LeBaggett/Control-Device-Electral-Method/hardware/mvp/communication/README.md

# RS-485 e conexões

Transceptores MAX485, níveis elétricos, DE/RE, terminação e barramentos independentes de IHM/sensores.

Estado: estrutura inicial criada em 26/10/2026.

Validar compatibilidade entre transceptor de 5 V e pinos de 3,3 V; não unir mestres RTU no mesmo barramento.

## Manutenção

Implementações futuras devem manter as responsabilidades desta camada e atualizar este README com os arquivos efetivamente criados. Arquivos de outras gerações não devem ser copiados sem revisão de interfaces e premissas.
