LeBaggett/Control-Device-Electral-Method/fw/Control_Device_Electral_Method_MVP/Drivers/README.md

# Dependências ST/ARM

Destino das bibliotecas geradas para o H753. Não há HAL/CMSIS H7 importados nesta etapa.

Estado: estrutura inicial criada em 26/10/2026.

Preservar licenças e manter fontes/headers compatíveis com o pacote STM32CubeH7 selecionado.

## Subpastas

- [CMSIS](CMSIS/README.md)
- [STM32H7xx_HAL_Driver](STM32H7xx_HAL_Driver/README.md)

## Manutenção

Implementações futuras devem manter as responsabilidades desta camada e atualizar este README com os arquivos efetivamente criados. Arquivos de outras gerações não devem ser copiados sem revisão de interfaces e premissas.
