LeBaggett/Control-Device-Electral-Method/fw/testbench/MVP_H753_Hardware_Bench/tools/README.md

# Ferramentas

build.py compila com GCC ARM; embed_web.py atualiza o array da página. Não modificam CubeIDE global nem gravam a placa.
