LeBaggett/Control-Device-Electral-Method/fw/Control_Device_Electral_Method_MVP/Application/interfaces/README.md

# Contratos de integração

Tipos e interfaces compartilhados por core, drivers e adaptadores HTTP/Modbus.

Estado: estrutura inicial criada em 26/10/2026.

Definir unidades, estados, validade e idade das três temperaturas, identificador da sessão, comandos e códigos de falha. IHM e navegador devem obedecer aos mesmos estados e arbitragem de comandos.

## Manutenção

Implementações futuras devem manter as responsabilidades desta camada e atualizar este README com os arquivos efetivamente criados. Arquivos de outras gerações não devem ser copiados sem revisão de interfaces e premissas.
