LeBaggett/Control-Device-Electral-Method/fw/Control_Device_Electral_Method_MVP/Core/Inc/README.md

# Headers gerados

Destino de main.h, stm32h7xx_it.h e configuração HAL do H753.

Estado: estrutura inicial criada em 26/10/2026.

Não copiar definições de STM32F407 para esta pasta.

## Manutenção

Implementações futuras devem manter as responsabilidades desta camada e atualizar este README com os arquivos efetivamente criados. Arquivos de outras gerações não devem ser copiados sem revisão de interfaces e premissas.
