LeBaggett/Control-Device-Electral-Method/fw/Control_Device_Electral_Method/Application/interfaces/README.md

# interfaces - guia de manutenção

Contratos compartilhados sem detalhes da placa, como eventos do encoder.

Documentação revisada em 26/10/2026. Os comentários e guias não alteram a lógica executável.

## Arquivos e implementações

| Arquivo | Responsabilidade e manutenção |
|---|---|
| [input_event.h](input_event.h) | Contrato de eventos de entrada independente do driver do encoder. |

## Observações para manutenção

Antes de alterar interfaces, procure seus consumidores e testes. Após mudanças, revise o diff e compile o projeto correspondente; confirme em bancada quando houver efeito elétrico ou temporal.

[Voltar à pasta superior](../README.md)
