LeBaggett/Control-Device-Electral-Method/fw/Control_Device_Electral_Method/Core/Startup/README.md

# Startup - guia de manutenção

Entrada, inicializações geradas, handlers e startup do STM32. Preservar USER CODE e revisar o diff após regenerar o .ioc.

Documentação revisada em 26/10/2026. Os comentários e guias não alteram a lógica executável.

## Arquivos e implementações

| Arquivo | Responsabilidade e manutenção |
|---|---|
| [startup_stm32f407vetx.s](startup_stm32f407vetx.s) | Tabela de vetores, Reset_Handler e entrada no runtime C para o MCU indicado no nome. Vinculado ao linker script. |

## Observações para manutenção

Antes de alterar interfaces, procure seus consumidores e testes. Após mudanças, revise o diff e compile o projeto correspondente; confirme em bancada quando houver efeito elétrico ou temporal.

[Voltar à pasta superior](../README.md)
