LeBaggett/Control-Device-Electral-Method/fw/testbench/MVP_H753_Hardware_Bench/Core/Inc/README.md

# Configuração do alvo

main.h expõe fatal/error handler; stm32h7xx_hal_conf.h seleciona HAL e opções do alvo.
