LeBaggett/Control-Device-Electral-Method/fw/testbench/MVP_H753_Hardware_Bench/Core/Src/README.md

# Execução no MCU

main.c: boot/superloop; stm32h7xx_it.c: SysTick/ETH/falhas; system_stm32h7xx.c: ST; syscalls.c: operações libc não suportadas e heap limitado.
