LeBaggett/Control-Device-Electral-Method/fw/testbench/Driver_Hardware_Bench/SD_MOUNT_TRACE.md

SD mount diagnostic only. Execute TESTAR SD then pause. Inspect g_sd_io_debug.sector_trace_count and sector_trace[0..count-1]. signature should be 43605 (0xAA55). Sector 0 may be an MBR; its BPB fields are then not meaningful. first_partition_lba identifies the FAT volume boot sector; that record should have bytes_per_sector=512 and fat_type="FAT32   ". Four distinct successful read headers retained. No card formatting or raw writes added; existing explicit SD roundtrip still creates BCHnnn.TXT only after a successful mount. Main, OLED and manual power behavior unchanged.
