LeBaggett/Control-Device-Electral-Method/fw/Control_Device_Electral_Method/EXFAT_SUPPORT.md

FAT12/16/32 and exFAT supported with the bundled FatFs R0.12c. _FS_EXFAT=1 and required _USE_LFN=1 (static buffers, single serialized superloop access, no heap). CP850 conversion/Unicode uppercase implementation comes from the installed ST F4 V1.28.3 FatFs option/ccsbcs.c; integrated as src/ff_unicode.c, preserving original copyright. Do not add another unicode.c/ccsbcs.c translation unit that defines the same functions. CubeMX settings recorded in .ioc. Recheck ffconf.h after regeneration. g_sd_filesystem_type: 0=no successful current mount, 3=FAT32, 4=exFAT. No card formatting, existing file replacement, pin, OLED, or power behavior changes. Hardware validation pending.
