LeBaggett/Control-Device-Electral-Method/hardware/README.md

# Hardware do dispositivo

Documentação e projetos de circuitos, separados dos fontes de firmware.

Estado: estrutura inicial criada em 26/10/2026.

A nova geração está em [mvp](mvp/README.md). Nenhuma placa ou lista de materiais está finalizada nesta etapa.

## Subpastas

- [mvp](mvp/README.md)

## Manutenção

Implementações futuras devem manter as responsabilidades desta camada e atualizar este README com os arquivos efetivamente criados. Arquivos de outras gerações não devem ser copiados sem revisão de interfaces e premissas.
