LeBaggett/Control-Device-Electral-Method/hmi/README.md

# Interfaces industriais

Projetos de IHM industrial e seus contratos de comunicação.

Estado: estrutura inicial criada em 26/10/2026.

A nova geração está em [mvp](mvp/README.md); projetos DOPSoft serão adicionados após fechar telas e mapas.

## Subpastas

- [mvp](mvp/README.md)

## Manutenção

Implementações futuras devem manter as responsabilidades desta camada e atualizar este README com os arquivos efetivamente criados. Arquivos de outras gerações não devem ser copiados sem revisão de interfaces e premissas.
