LeBaggett/Control-Device-Electral-Method/hardware/mvp/power/README.md

# Fonte de corrente e proteção

Requisitos, cálculo e esquema da fonte do DUT com correntes fixas ajustadas no circuito. Sem telemetria de corrente e sem ajuste de corrente por firmware.

Estado: estrutura inicial criada em 26/10/2026.

Pendentes datasheets DDR5/LPDDR5, ponto termossensível acessível, domínios de tensão, correntes, compliance e limites.

## Manutenção

Implementações futuras devem manter as responsabilidades desta camada e atualizar este README com os arquivos efetivamente criados. Arquivos de outras gerações não devem ser copiados sem revisão de interfaces e premissas.
