LeBaggett/Control-Device-Electral-Method/hardware/mvp/fixture/README.md

# Fixture das memórias

Conexões e montagem térmica/elétrica dos DUTs DDR5/LPDDR5.

Estado: estrutura inicial criada em 26/10/2026.

Confirmar nos datasheets acesso ao sinal termossensível, polarização permitida e forma de aquecimento.

## Manutenção

Implementações futuras devem manter as responsabilidades desta camada e atualizar este README com os arquivos efetivamente criados. Arquivos de outras gerações não devem ser copiados sem revisão de interfaces e premissas.
