LeBaggett/Control-Device-Electral-Method/hardware/mvp/heater/README.md

# Aquecedor externo

Requisitos e interface de potência do aquecedor comandado pelo STM32.

Estado: estrutura inicial criada em 26/10/2026.

Modelo, tensão, potência, faixa e necessidade de resfriamento ainda em aberto. Não definir atuador antes desses requisitos.

## Manutenção

Implementações futuras devem manter as responsabilidades desta camada e atualizar este README com os arquivos efetivamente criados. Arquivos de outras gerações não devem ser copiados sem revisão de interfaces e premissas.
