LeBaggett/Control-Device-Electral-Method/hardware/mvp/temperature/README.md

# Três canais de temperatura

Termopares J/K, indicadores/conversores, posicionamento e identificação de cada canal.

Estado: estrutura inicial criada em 26/10/2026.

Definir quantidade de N1040i ou alternativa multicanal. Aquisição serial sequencial não implica três amostras simultâneas.

## Manutenção

Implementações futuras devem manter as responsabilidades desta camada e atualizar este README com os arquivos efetivamente criados. Arquivos de outras gerações não devem ser copiados sem revisão de interfaces e premissas.
