LeBaggett/Control-Device-Electral-Method/fw/Control_Device_Electral_Method_MVP/LWIP/README.md

# Integração Ethernet

Estrutura de integração da pilha LwIP com HAL Ethernet e aplicação HTTP.

Estado: estrutura inicial criada em 26/10/2026.

Integração sem RTOS (NO_SYS): atendimento periódico da entrada Ethernet e dos timeouts da pilha, usando API compatível com esse modo. Transporte de dados e interface web não substituem armazenamento persistente. Separar aquisição crítica de envio TCP/HTTP.

## Subpastas

- [App](App/README.md)

- [Target](Target/README.md)

## Manutenção

Implementações futuras devem manter as responsabilidades desta camada e atualizar este README com os arquivos efetivamente criados. Arquivos de outras gerações não devem ser copiados sem revisão de interfaces e premissas.
