LeBaggett/Control-Device-Electral-Method/docs/mvp/interfaces/README.md

# Contratos entre sistemas

Especificação versionada da API HTTP e dos mapas Modbus.

Estado: estrutura inicial criada em 26/10/2026.

Estabelecer unidades, timestamp, validade, códigos de erro e comandos idempotentes antes de implementar dois clientes.

## Manutenção

Implementações futuras devem manter as responsabilidades desta camada e atualizar este README com os arquivos efetivamente criados. Arquivos de outras gerações não devem ser copiados sem revisão de interfaces e premissas.
