LeBaggett/Control-Device-Electral-Method/fw/Control_Device_Electral_Method_MVP/Core/README.md

# Código gerado do STM32

Destino previsto para startup, handlers e inicializações CubeMX. Ainda não há geração H753.

Estado: estrutura inicial criada em 26/10/2026.

Revisar USER CODE e a relação entre main, MSP, interrupções e inicialização segura após gerar o projeto.

## Subpastas

- [Inc](Inc/README.md)
- [Src](Src/README.md)
- [Startup](Startup/README.md)

## Manutenção

Implementações futuras devem manter as responsabilidades desta camada e atualizar este README com os arquivos efetivamente criados. Arquivos de outras gerações não devem ser copiados sem revisão de interfaces e premissas.
