LeBaggett/Control-Device-Electral-Method/hmi/mvp/protocol/README.md

# Contrato IHM/STM32

Mapa de registradores e comandos, escala, endianess, permissões e respostas.

Estado: estrutura inicial criada em 26/10/2026.

Registrar unidade e versão do protocolo. Comando rejeitado deve apresentar motivo; não escrever diretamente em GPIO.

## Manutenção

Implementações futuras devem manter as responsabilidades desta camada e atualizar este README com os arquivos efetivamente criados. Arquivos de outras gerações não devem ser copiados sem revisão de interfaces e premissas.
