LeBaggett/Control-Device-Electral-Method/hmi/mvp/screens/README.md

# Telas da IHM

Especificação e recursos das telas operacionais.

Estado: estrutura inicial criada em 26/10/2026.

Revisar limites de edição, confirmação de partida e cancelamento com o estado real do STM32.

## Manutenção

Implementações futuras devem manter as responsabilidades desta camada e atualizar este README com os arquivos efetivamente criados. Arquivos de outras gerações não devem ser copiados sem revisão de interfaces e premissas.
