LeBaggett/Control-Device-Electral-Method/tools/thermal_analyzer_web/docs/README.md

# Documentação web

API, navegação, modelo de dados, decisões e instruções de build/publicação.

Estado: estrutura inicial criada em 26/10/2026.

Documentar quando a operação sem internet e a exportação estiverem implementadas e verificadas.

## Manutenção

Implementações futuras devem manter as responsabilidades desta camada e atualizar este README com os arquivos efetivamente criados. Arquivos de outras gerações não devem ser copiados sem revisão de interfaces e premissas.
