LeBaggett/Control-Device-Electral-Method/tools/thermal_analyzer_web/public/README.md

# Recursos estáticos

Arquivos a servir junto com a página, sem conexão à internet.

Estado: estrutura inicial criada em 26/10/2026.

Conferir orçamento de Flash e tamanho do bundle antes de embutir recursos no STM32.

## Subpastas

- [assets](assets/README.md)

## Manutenção

Implementações futuras devem manter as responsabilidades desta camada e atualizar este README com os arquivos efetivamente criados. Arquivos de outras gerações não devem ser copiados sem revisão de interfaces e premissas.
