LeBaggett/Control-Device-Electral-Method/tools/thermal_analyzer_web/src/README.md

# Fontes da interface web

Separação entre domínio, transporte, estado e apresentação.

Estado: estrutura inicial criada em 26/10/2026.

A seleção de framework/build será feita na implementação; não há dependências instaladas nesta estrutura.

## Subpastas

- [components](components/README.md)
- [domain](domain/README.md)
- [pages](pages/README.md)
- [services](services/README.md)
- [state](state/README.md)
- [styles](styles/README.md)

## Manutenção

Implementações futuras devem manter as responsabilidades desta camada e atualizar este README com os arquivos efetivamente criados. Arquivos de outras gerações não devem ser copiados sem revisão de interfaces e premissas.
