LeBaggett/Control-Device-Electral-Method/fw/testbench/MVP_H753_Hardware_Bench/Drivers/README.md

# Dependências de hardware

HAL/CMSIS/PHY ST, versões em DEPENDENCIES.json e PHY_VERSION.txt. Preservar os arquivos LICENSE originais.
