LeBaggett/Control-Device-Electral-Method/fw/Control_Device_Electral_Method_MVP/Application/docs/README.md

# Notas técnicas do firmware

Decisões de integração de periféricos, falhas observadas e justificativas de temporização.

Estado: estrutura inicial criada em 26/10/2026.

Registrar aqui observações específicas do código H753. O escopo geral está em `docs/mvp` na raiz do repositório.

## Manutenção

Implementações futuras devem manter as responsabilidades desta camada e atualizar este README com os arquivos efetivamente criados. Arquivos de outras gerações não devem ser copiados sem revisão de interfaces e premissas.
