LeBaggett/Control-Device-Electral-Method/fw/Control_Device_Electral_Method_MVP/Core/Startup/README.md

# Startup H753

Tabela de vetores e Reset_Handler específicos do MCU, a gerar com a toolchain.

Estado: estrutura inicial criada em 26/10/2026.

Startup e linker script devem corresponder ao STM32H753 e ao mapa de memória/cache adotado.

## Manutenção

Implementações futuras devem manter as responsabilidades desta camada e atualizar este README com os arquivos efetivamente criados. Arquivos de outras gerações não devem ser copiados sem revisão de interfaces e premissas.
