LeBaggett/Control-Device-Electral-Method/fw/Control_Device_Electral_Method_MVP/LWIP/App/README.md

# Serviços da rede

Destino das inicializações e serviços da integração LwIP gerados ou adaptados.

Estado: estrutura inicial criada em 26/10/2026.

Aplicar comandos por fila/contrato validado; não executar sessões térmicas dentro de callbacks HTTP.

## Manutenção

Implementações futuras devem manter as responsabilidades desta camada e atualizar este README com os arquivos efetivamente criados. Arquivos de outras gerações não devem ser copiados sem revisão de interfaces e premissas.
