LeBaggett/Control-Device-Electral-Method/fw/Control_Device_Electral_Method_MVP/LWIP/Target/README.md

# Portabilidade Ethernet

Destino de ethernetif e do adaptador de PHY/buffers.

Estado: estrutura inicial criada em 26/10/2026.

Confirmar PHY e revisão da placa. Revisar descritores, alinhamento e coerência de cache do DMA Ethernet.

## Manutenção

Implementações futuras devem manter as responsabilidades desta camada e atualizar este README com os arquivos efetivamente criados. Arquivos de outras gerações não devem ser copiados sem revisão de interfaces e premissas.
