LeBaggett/Control-Device-Electral-Method/tools/thermal_analyzer_web/public/assets/README.md

# Arte e recursos visuais

Logo, ícones e imagens aprovadas para a versão web.

Estado: estrutura inicial criada em 26/10/2026.

A splash original da POC permanece como referência; não há cópia/recriação de arte nesta etapa.

## Manutenção

Implementações futuras devem manter as responsabilidades desta camada e atualizar este README com os arquivos efetivamente criados. Arquivos de outras gerações não devem ser copiados sem revisão de interfaces e premissas.
