LeBaggett/Control-Device-Electral-Method/tools/thermal_analyzer_web/src/domain/README.md

# Domínio e cálculos

Modelos de ensaio, calibração, unidades, validações e métricas puras.

Estado: estrutura inicial criada em 26/10/2026.

Preservar brutos e origem de Tj. Conferir regras para potência/regime e não confundir temperatura de caixa com ambiente.

## Manutenção

Implementações futuras devem manter as responsabilidades desta camada e atualizar este README com os arquivos efetivamente criados. Arquivos de outras gerações não devem ser copiados sem revisão de interfaces e premissas.
