LeBaggett/Control-Device-Electral-Method/tools/thermal_analyzer_web/src/pages/README.md

# Páginas

Dashboard, configuração, calibração, ensaio TSP, resultados e manutenção.

Estado: estrutura inicial criada em 26/10/2026.

Planejar estados vazio, carregando, erro, desconectado e concluído, além do caso de sucesso.

## Manutenção

Implementações futuras devem manter as responsabilidades desta camada e atualizar este README com os arquivos efetivamente criados. Arquivos de outras gerações não devem ser copiados sem revisão de interfaces e premissas.
