LeBaggett/Control-Device-Electral-Method/tools/thermal_analyzer_web/src/services/README.md

# Comunicação e exportação

Adaptadores da API do STM32 e serviços de exportação de dados/relatórios.

Estado: estrutura inicial criada em 26/10/2026.

Tratar identificador de sessão, sequência, finalização, perda/reconexão e dados parciais.

## Manutenção

Implementações futuras devem manter as responsabilidades desta camada e atualizar este README com os arquivos efetivamente criados. Arquivos de outras gerações não devem ser copiados sem revisão de interfaces e premissas.
