LeBaggett/Control-Device-Electral-Method/tools/thermal_analyzer_web/src/state/README.md

# Estado de interface

Estado das telas, sessão observada, conexão e comandos pendentes.

Estado: estrutura inicial criada em 26/10/2026.

Arbitrar comandos entre clientes/IHM no dispositivo; estado local não é autoridade sobre a potência.

## Manutenção

Implementações futuras devem manter as responsabilidades desta camada e atualizar este README com os arquivos efetivamente criados. Arquivos de outras gerações não devem ser copiados sem revisão de interfaces e premissas.
