LeBaggett/Control-Device-Electral-Method/tools/thermal_analyzer_web/src/styles/README.md

# Estilos

Layout e identidade visual da interface CAIS.

Estado: estrutura inicial criada em 26/10/2026.

Definir cores e tipografia reutilizáveis, contraste e layout adaptável sem poluir as telas com detalhes de firmware.

## Manutenção

Implementações futuras devem manter as responsabilidades desta camada e atualizar este README com os arquivos efetivamente criados. Arquivos de outras gerações não devem ser copiados sem revisão de interfaces e premissas.
