LeBaggett/Control-Device-Electral-Method/fw/testbench/MVP_H753_Hardware_Bench/LWIP/App/README.md

# Serviço de rede

net_service.c/.h configura IPv4, MAC local baseada no UID, interface LwIP e HTTPD; executa timeouts, RX e liberação de TX no mainloop.
