LeBaggett/Control-Device-Electral-Method/fw/testbench/MVP_H753_Hardware_Bench/LWIP/Target/arch/README.md

# Portabilidade LwIP

cc.h define assert, diagnóstico e gerador simples para uso de bancada. Não representa um serviço de autenticação ou aleatoriedade criptográfica.
