LeBaggett/Control-Device-Electral-Method/tools/thermal_analyzer_web/src/components/README.md

# Componentes visuais

Controles reutilizáveis, indicadores de três temperaturas, tabelas e gráficos.

Estado: estrutura inicial criada em 26/10/2026.

Mostrar unidades e idade/validade das leituras; evitar apresentar dado antigo como medição atual.

## Manutenção

Implementações futuras devem manter as responsabilidades desta camada e atualizar este README com os arquivos efetivamente criados. Arquivos de outras gerações não devem ser copiados sem revisão de interfaces e premissas.
