LeBaggett/Control-Device-Electral-Method/fw/Control_Device_Electral_Method_MVP/Application/tests/README.md

# Testes de lógica no computador

Testes das máquinas de estado, cálculos e contratos, com drivers simulados. Não incluir estas fontes na imagem STM32.

Estado: estrutura inicial criada em 26/10/2026.

Testar sequência segura, falhas, dados vencidos, cancelamento, perda de comunicação e persistência parcial. Importar casos da POC somente depois de revisar premissas de hardware e protocolo.

## Subpastas

- [stubs](stubs/README.md)

## Manutenção

Implementações futuras devem manter as responsabilidades desta camada e atualizar este README com os arquivos efetivamente criados. Arquivos de outras gerações não devem ser copiados sem revisão de interfaces e premissas.
