LeBaggett/Control-Device-Electral-Method/docs/mvp/validation/README.md

# Plano de validação

Critérios e resultados de testes por etapa do MVP.

Estado: estrutura inicial criada em 26/10/2026.

Separar evidência de teste simulado, compilação e medição física. Ainda não há resultados de bancada H753.

## Manutenção

Implementações futuras devem manter as responsabilidades desta camada e atualizar este README com os arquivos efetivamente criados. Arquivos de outras gerações não devem ser copiados sem revisão de interfaces e premissas.

## Entregas

- [Etapa 1: base H753 e Ethernet](ETAPA_01_BASE_ETHERNET.md): implementação e compilação verificadas; testes físicos pendentes.
