LeBaggett/Control-Device-Electral-Method/tools/thermal_analyzer_web/tests/README.md

# Testes web

Equivalência dos cálculos, importação/transporte e estados da interface.

Estado: estrutura inicial criada em 26/10/2026.

Usar dados sintéticos identificados e fixtures conhecidos do Analyzer; não converter NaN/ausência em zero.

## Subpastas

- [fixtures](fixtures/README.md)

## Manutenção

Implementações futuras devem manter as responsabilidades desta camada e atualizar este README com os arquivos efetivamente criados. Arquivos de outras gerações não devem ser copiados sem revisão de interfaces e premissas.
