LeBaggett/Control-Device-Electral-Method/tools/thermal_analyzer_web/tests/fixtures/README.md

# Dados de referência

Exemplos versionados para comparar cálculos Python e web.

Estado: estrutura inicial criada em 26/10/2026.

Não incluir dados pessoais ou resultados reais sem identificar origem e condições de uso.

## Manutenção

Implementações futuras devem manter as responsabilidades desta camada e atualizar este README com os arquivos efetivamente criados. Arquivos de outras gerações não devem ser copiados sem revisão de interfaces e premissas.
