LeBaggett/Control-Device-Electral-Method/fw/Control_Device_Electral_Method_MVP/Application/tests/stubs/README.md

# Stubs de testes

Substitutos controlados da HAL, relógio e periféricos para executar testes no computador.

Estado: estrutura inicial criada em 26/10/2026.

Não usar stubs no build do dispositivo. Cada simulação deve expor explicitamente timeout, sucesso, erro e conteúdo dos dados necessários ao teste.

## Manutenção

Implementações futuras devem manter as responsabilidades desta camada e atualizar este README com os arquivos efetivamente criados. Arquivos de outras gerações não devem ser copiados sem revisão de interfaces e premissas.
