LeBaggett/Control-Device-Electral-Method/fw/testbench/Driver_Hardware_Bench/SD_COMPLETE_READ_FIX.md

Bench-only SDIO polling correction: clear stale data flags before each HAL read; reject incomplete payload (dataremaining!=0) instead of returning HAL_OK. Explicit TESTAR SD reinitializes the HAL handle and SDIO peripheral. No automatic writes/retries added. 1-bit/400kHz and power/manual IO behavior preserved. HAL source patch must be retained if the vendor driver is regenerated/replaced. This guards a code path; hardware cause of the intermittent SD failure remains unverified.
