LeBaggett/Control-Device-Electral-Method/fw/testbench/Driver_Hardware_Bench/Core/Src/main.c

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
/* Includes ------------------------------------------------------------------*/
#include "main.h"
#include "fatfs.h"

/* USER CODE BEGIN Includes */
#include "app.h"
#include "board.h"
#include "pinout.h"
#include "sd_io.h"
#include "runtime_config.h"
#include "bench_config.h"
#include "bench_led.h"
/* USER CODE END Includes */

ADC_HandleTypeDef hadc1;

I2C_HandleTypeDef hi2c1;

SD_HandleTypeDef hsd;

SPI_HandleTypeDef hspi1;

TIM_HandleTypeDef htim2;

void SystemClock_Config(void);
static void MX_GPIO_Init(void);
static void MX_ADC1_Init(void);
static void MX_SDIO_SD_Init(void);
static void MX_SPI1_Init(void);
static void MX_TIM2_Init(void);
static void MX_I2C1_Init(void);
/**
  * @brief  The application entry point.
  * @retval int
  */
int main(void)
{

  /* USER CODE BEGIN 1 */
  board_init();
  app_init();
  for (;;) { app_run(); }
/* USER CODE END 1 */

  /* MCU Configuration--------------------------------------------------------*/

  /* Reset of all peripherals, Initializes the Flash interface and the Systick. */
  HAL_Init();

  /* Configure the system clock */
  SystemClock_Config();

  /* Initialize all configured peripherals */
  MX_GPIO_Init();
  MX_ADC1_Init();
  MX_SDIO_SD_Init();
  MX_SPI1_Init();
  MX_TIM2_Init();
  MX_FATFS_Init();
  MX_I2C1_Init();
  /* Infinite loop */
  /* USER CODE BEGIN WHILE */
  while (1)
  {
    /* USER CODE END WHILE */

    /* USER CODE BEGIN 3 */
  }
  /* USER CODE END 3 */
}

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
/* USER CODE BEGIN 4 */
void board_cube_clock_init(void) { SystemClock_Config(); }
void board_cube_gpio_init(void) { MX_GPIO_Init(); }
void board_cube_peripherals_init(void)
{
#if BENCH_TEST_MAX31855
    MX_SPI1_Init();
#endif
#if BENCH_TEST_ADC
    MX_ADC1_Init();
#endif
#if BENCH_TEST_OLED
    MX_I2C1_Init();
#endif
#if BENCH_TEST_ENCODER
    MX_TIM2_Init();
#endif
#if BENCH_TEST_SD
    MX_FATFS_Init(); /* Register driver only; card init is a manual action. */
#endif
}
/* USER CODE END 4 */
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
