LeBaggett/Control-Device-Electral-Method/fw/testbench/Driver_Hardware_Bench/Driver_Hardware_Bench.ioc

Mcu.UserName=STM32F407VETx
PA1.GPIO_Label=BENCH_LED
PA1.Signal=GPIO_Output
PA13.Signal=SYS_JTMS-SWDIO
PA14.Signal=SYS_JTCK-SWCLK
PA15.Signal=S_TIM2_CH1_ETR
PA4.GPIO_Label=MAX31855 CS
PA4.Signal=GPIO_Output
PA5.Signal=SPI1_SCK
PA6.Signal=SPI1_MISO
PA7.Signal=SPI1_MOSI
PB3.Signal=S_TIM2_CH2
PB8.Signal=I2C1_SCL
PB9.Signal=I2C1_SDA
PC0.Signal=ADCx_IN10
PC10.Signal=SDIO_D2
PC11.Signal=SDIO_D3
PC12.Signal=SDIO_CK
PC8.Signal=SDIO_D0
PC9.Signal=SDIO_D1
PD12.GPIO_Label=SELECT
PD12.Signal=GPIO_Output
PD14.GPIO_Label=Relay
PD14.Signal=GPIO_Output
PD2.Signal=SDIO_CMD
PE2.GPIO_Label=SW
PE2.Signal=GPIO_Input
PH0-OSC_IN.Signal=RCC_OSC_IN
PH1-OSC_OUT.Signal=RCC_OSC_OUT
