LeBaggett/Control-Device-Electral-Method/fw/Control_Device_Electral_Method/Core/Inc/main.h

#define SW_Pin GPIO_PIN_2
#define SW_GPIO_Port GPIOE
#define MAX31855_CS_Pin GPIO_PIN_4
#define MAX31855_CS_GPIO_Port GPIOA
#define Relay_Pin GPIO_PIN_14
#define Relay_GPIO_Port GPIOD
#define SELECT_Pin GPIO_PIN_12
#define SELECT_GPIO_Port GPIOD
