LeBaggett/Control-Device-Electral-Method/(commit log)

2026-10-14 feat(core): regressão, alvos, conversões de RTD e Vf
2026-10-14 feat(fw): Primeira versão completa sem acionamento de aquecimento e mensuração
2026-10-18 feat(fw): Versão estável com prova de conceito ok e software thermal analyzer
2026-10-26 fix(fw): restore delivered stable firmware from SD fix source archive
    Import the delivered Control_Device_Electral_Method_SD_fix_20dfbf5_source.zip firmware sources. Preserve unrelated local testbench and analyzer files. Verified all 188 archive files and passed ARM compilation and linking; hardware operation reported by the project owner.
2026-10-26 docs: add maintenance guides and explain critical implementation paths
    Document source, testbench, analyzer and dependency directories with file inventories, entry points and maintenance notes. Replace obsolete top-level/Application guidance and preserve specialized prior documentation. Explain safe initialization, ADC reference timing, TSP capture and SD write behavior without changing executable tokens. ARM binary matches the delivered version; all 11 analyzer tests and 1192 current guide links checked.
2026-10-26 docs(mvp): establish H753 industrial platform scope and migration plan
    Record H753ZI, industrial HMI, three J/K thermocouples, RS485 DMA/interrupts, DDR5/LPDDR5 current-source requirements and pending heater/fixture decisions. No H753 hardware implementation is claimed.
2026-10-26 chore(mvp): scaffold H753 firmware, web, hardware and HMI directories
    Mirror the POC board/drivers/core/interfaces/ui separation in an independent H753 project. Add documented slots for generated Core/HAL/LwIP, diagnostics, browser analysis, hardware and HMI. No executable implementation, guessed pin map or CubeMX project is introduced. Preserve the POC reference sources.
2026-10-26 docs(mvp): choose no-RTOS execution and fixed currents without telemetry
2026-10-26 feat(bench): add no-RTOS H753 base and Ethernet diagnostic firmware
    Bring up NUCLEO-H753ZI/MB1364 using pinned ST HAL/CMSIS/LAN8742 and LwIP NO_SYS. Provide LED heartbeat, retained debug state, bounded Ethernet service, asynchronous TX, read-only HTTP dashboard and JSON status. Include importable CubeIDE project, CLI build, host tests and strategy/bench instructions. ARM and CubeIDE builds passed; hardware validation remains pending. No RS485, ADC/TSP or power outputs are implemented in this stage.
2026-11-10 feat(mvp): add read-only N1040i RS485 bench with DMA and web diagnostics
2026-11-10 fix(mvp): disable internal pulls on externally driven UART RX
