LeBaggett/Control-Device-Electral-Method/(notices)

Notices in the files:
fw/testbench/Driver_Hardware_Bench/Core/Src/main.c:
Copyright (c) 2026 STMicroelectronics.
All rights reserved.
This software is licensed under terms that can be found in the LICENSE file
